lucanatorvs/refactored-robot/README.md

# refactored-robot
Combined Charging System Communication (CCSC)
