lucanatorvs/refactored-robot/StageVerslag/Abbrev.tex

\DeclareAcronym{ev}{
    short = {EV} ,
    long  = {Electric Vehicle} ,
    foreign  = {Elektrisch Voertuig} ,
    class = {abbrev}
}
\DeclareAcronym{evse}{
    short = {EVSE} ,
    long  = {Electric Cehicle Supply Equipment (EV charger)} ,
    foreign  = {Oplaadpunt} ,
    class = {abbrev}
}
\DeclareAcronym{ccs}{
    short = {CCS} ,
    long  = {Combined Charging System} ,
    foreign  = {Gecombineerd Laadsysteem} ,
    class = {abbrev}
}
\DeclareAcronym{ecu}{
    short = {ECU} ,
    long  = {Electronic Control Unit} ,
    foreign  = {Elektronische Regel Module} ,
    class = {abbrev}
}
\DeclareAcronym{hv}{
    short = {HV} ,
    long  = {High Voltage} ,
    foreign  = {Hoogspanning} ,
    class = {abbrev}
}
\DeclareAcronym{lv}{
    short = {LV} ,
    long  = {Low Voltage} ,
    foreign  = {Laagspanning} ,
    class = {abbrev}
}
\DeclareAcronym{ac}{
    short = {AC} ,
    long  = {Alternating Current} ,
    foreign  = {Wisselstroom} ,
    class = {abbrev}
}
\DeclareAcronym{dc}{
    short = {DC} ,
    long  = {Direct Current} ,
    foreign  = {Gelijkstroom} ,
    class = {abbrev}
}
\DeclareAcronym{can}{
    short = {CAN} ,
    long  = {Controller Area Network} ,
    foreign  = {Controller Gebiedsnetwerk} ,
    class = {abbrev}
}
\DeclareAcronym{bms}{
    short = {BMS} ,
    long  = {Battery Management System} ,
    foreign  = {Batterijbeheer Systeem} ,
    class = {abbrev}
}
\DeclareAcronym{hvil}{
    short = {HVIL} ,
    long  = {High Voltage Interlock Loop} ,
    foreign  = {Hoogspanning Interlock Lus} ,
    class = {abbrev}
}
\DeclareAcronym{hvi}{
    short = {HVIL} ,
    long  = {High Voltage Interlock} ,
    foreign  = {Hoogspanning Interlock} ,
    class = {abbrev}
}
\DeclareAcronym{pwm}{
    short = {PWM} ,
    long  = {Pulse Width Modulation} ,
    foreign  = {Pulsbreedte Modulatie} ,
    class = {abbrev}
}
\DeclareAcronym{soc}{
    short = {SOC} ,
    long  = {State of charge} ,
    foreign  = {Oplaad Niveau} ,
    class = {abbrev}
}
\DeclareAcronym{soh}{
    short = {SOH} ,
    long  = {Conditie} ,
    foreign  = {Oplaadstaat} ,
    class = {abbrev}
}
\DeclareAcronym{rdw}{
    short = {RDW} ,
    long  = {Rijksdienst voor het Wegverkeer} ,
    class = {abbrev}
}
\DeclareAcronym{dbc}{
    short = {DBC} ,
    long  = {CAN bus databases} ,
    foreign  = {CAN-Bus-Databases} ,
    class = {abbrev}
}
\DeclareAcronym{spi}{
    short = {SPI} ,
    long  = {Serial Peripheral Interface} ,
    foreign  = {Seriële Randapparatuur Interface} ,
    class = {abbrev}
}
\DeclareAcronym{ide}{
    short = {IDE} ,
    long  = {Integrated Development Environment} ,
    foreign  = {Geïntegreerde Ontwikkelomgeving} ,
    class = {abbrev}
}
\DeclareAcronym{psu}{
    short = {PSU} ,
    long  = {Power Supply Unit} ,
    foreign  = {Voeding} ,
    class = {abbrev}
}
\DeclareAcronym{usb}{
    short = {USB} ,
    long  = {Universal Serial Bus} ,
    foreign  = {Universelle Seriele Bus} ,
    class = {abbrev}
}
