lucanatorvs/refactored-robot/StageVerslag/Sources/Eindresultaat.tex

\chapter{Eindresultaat}
\label{Eindresultaat}
%%%%%%%%%%%%%%%%%%%%%%%%%%%%%%%%%%%%%%%%%%%%%%%%%%%%%%%%%%%%%%%%%%%%%%%%

Het eindresultaat is een kleine behuizing met een Arduino Pro Mini, een MPC2515
module, een DC-DC converter (als \ac{psu}) en een generieke \ac{usb}-serial
convertor (alleen nodig voor een Arduino Pro Mini).

Deze onderdelen zijn gekozen omdat ze makkelijk te verkrijgen en goedkoop
waren (en voor een groot deel op voorraad).

%%%%%%%%%%%%%%%%%%%%%%%%%%%%%%%%%%%%%%%%%%%%%%%%%%%%%%%%%%%%%%%%%%%%%%%%
\section{Schema}
%%%%%%%%%%%%%%%%%%%%%%%%%%%%%%%%%%%%%%%%%%%%%%%%%%%%%%%%%%%%%%%%%%%%%%%%

\begin{figure}[]
    \centering
    
    \caption{Schema van de bedrading van de CAN-controller aan de Arduino \cite{autowp}}
    \label{fig:wiring}
\end{figure}

In het schema in figuur \ref{fig:wiring} is te zien hoe de Arduino de
CAN-controller aan kan sturen. En hoe de Arduino gevoed word met de
\si{12\volt} uit de auto.

%%%%%%%%%%%%%%%%%%%%%%%%%%%%%%%%%%%%%%%%%%%%%%%%%%%%%%%%%%%%%%%%%%%%%%%%
\section{Behuizing}
%%%%%%%%%%%%%%%%%%%%%%%%%%%%%%%%%%%%%%%%%%%%%%%%%%%%%%%%%%%%%%%%%%%%%%%%

\begin{figure}[]
    \centering
    \begin{minipage}{0.45\textwidth}
        \centerline{}
        \caption{Behuizing van de CCS CAN controller}
        \label{fig:behuizing}
    \end{minipage}\hfill
    \begin{minipage}{0.45\textwidth}
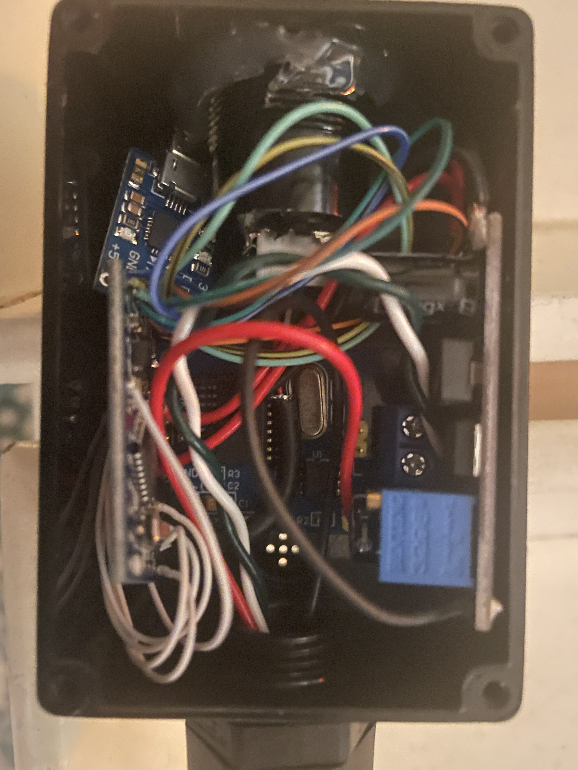
[picture p3: StageVerslag/Pictures/binnenkant.JPG]
        \centerline{}
        \caption{Binnenkant van de behuizing}
        \label{fig:binnenkant}
    \end{minipage}
\end{figure}

\begin{figure}[]
    \centering
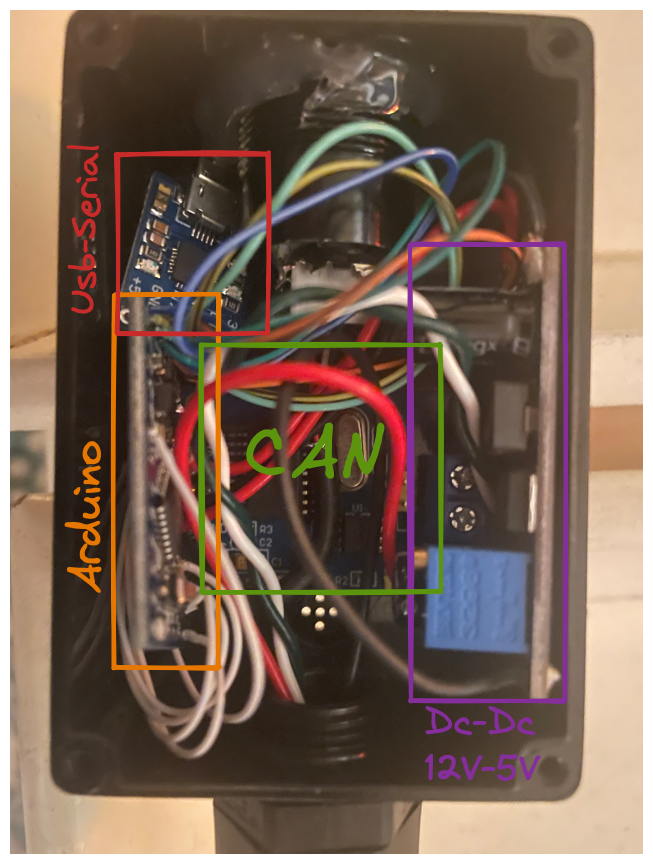
[picture p4: StageVerslag/Pictures/binnenkant_geanoteerd.png]
    
    \caption{Binnenkant van de behuizing, met een aantal notaties van de verschillende onderdelen}
    \label{fig:binnenkant_geanoteerd}
\end{figure}

In figuur \ref{fig:behuizing} is het eindresultaat te zien, een kleine lasdoos
is gebruikt als behuizing. De lasdoos heeft aan een kant een wartel als
doorvoer van de CAN bus en de \si{12\volt} uit de auto en aan de andere kant
een panel mount USB aansluiting. De USB aansluiting is om de Arduino te kunnen
programmeren. In figuur \ref{fig:binnenkant} en \ref{fig:binnenkant_geanoteerd} is de binnenkant van de behuizing
te zien. Het is best krap aan de binnenkant, maar alles past wel omdat er geen
gebruik meer word gemaakt van headers (zoals in het prototype), maar alle
verbindingen zijn direct aan de pcb's gesoldeerd.
