lucanatorvs/refactored-robot/StageVerslag/Sources/Titel.tex

\begin{titlepage}
    \vspace*{5cm}
    \makeatletter
    \begin{center}
        \begin{Huge}
            \@title
        \end{Huge}\\[0.1cm]
        %
        \begin{Large}
            \@subtitle
        \end{Large}\\
        %
        \emph{door}\\
        \@author
        %
        \vfill
        Dit document is opgesteld voor de stage bij EV Europe. Luca van
        Straaten is een student Elektrotechniek aan de Haagse Hogeschool te
        Delft.\\
        \vspace{.5cm}
        Datum: \today\\
        Versie: 1.0
    \end{center}
    \makeatother
\end{titlepage}

\newpage
