lucanatorvs/refactored-robot/StageVerslag/Sources/Voorwoord.tex

\chapter*{Voorwoord}
\addcontentsline{toc}{chapter}{Voorwoord}
%%%%%%%%%%%%%%%%%%%%%%%%%%%%%%%%%%%%%%%%%%%%%%%%%%%%%%%%%%%%%%%%%%%%%%%%

Dit ontwerpdocument is geschreven als documentatie van het tweede stagetraject
van Luca van Straaten.\\\

Dank gaat naar EV Europe voor de mogelijkheid om bij hun mijn tweede stage te
doen, te leren en groeien, nu en in de toekomst.\\\

Dit verslag is bedoeld voor mijn stage beoordeler om te beoordelen of ik
voldoende heb gepresteerd tijdens mijn stage, voor EV Europe en de mensen die
daar werken en verder moeten bouwen op mijn werk en voor Nederlandstalige
geïnteresseerden in het project. Een Engels vertaalde versie van dit verslag
is momenteel niet beschikbaar.\\\

Tijdens dit project is gewerkt in git, en alle bestanden staan op github. Als
iemand beniewd is naar bijvoorbeeld de arduino code, dan kan deze gedowload
worden van mijn \href{https://github.com/lucanatorvs}{GitHub} account onder de
project naam
\href{https://github.com/lucanatorvs/refactored-robot}{refactored-robot}.\\\

Delft, Januari 2022\\Luca van Straaten
