lucanatorvs/refactored-robot/StageVerslag/Sources/Conclusie_en_aanbevelingen.tex

\chapter{Conclusie en aanbevelingen}
\label{Conclusie_en_aanbevelingen}
%%%%%%%%%%%%%%%%%%%%%%%%%%%%%%%%%%%%%%%%%%%%%%%%%%%%%%%%%%%%%%%%%%%%%%%%

Uit dit verslag kan geconcludeerd worden dat dit project geslaagd is omdat het
product op tijd werd opgeleverd, en voldoet aan alle gestelde eisen.

Echter zijn er wel een aantal punten die kunnen worden verbeterd als dit
product in de toekomst vaak word verkocht. Zo kunnen alle losse onderdelen die
nu in de behuizing zitten op een pcb worden gezet, om zo een robuuster product
te maken dat makkelijk te produceren en waarschijnlijk ook nog goedkoper is.
Een CAN-controller zoals dit kan ook nog ander toepassingen hebben voor een
bedrijf als EV Europe.\\

Dat is niet nodig als de producent van het BMS direct firmware zou kunnen
leveren dat de juiste data aan het CCS-modem aanlevert. Als dat wordt gedaan,
dan zal het product niet meer nodig zijn en om Elon Musk te citeren, het beste
component, is geen component.
