lucanatorvs/refactored-robot/StageVerslag/Sources/Samenvatting.tex

\chapter{Samenvatting}
\label{Samenvatting}
%%%%%%%%%%%%%%%%%%%%%%%%%%%%%%%%%%%%%%%%%%%%%%%%%%%%%%%%%%%%%%%%%%%%%%%%

\begin{center}
    \begin{minipage}{0.5\textwidth}
        \begin{small}
            Waar in het kort het project van begin tot eind wordt beschreven.
        \end{small}
    \end{minipage}
    \vspace{0.5cm}
\end{center}

Er moest een systeem worden ontworpen om CCS snelladen te implementeren in een
elektrische auto. Er zijn verschillende optie overwogen, zoals zelf alle
elektronica ontwerpen. Maar uiteindelijk is er voor gekozen om een modem van
Zero-EV te gebruiken. Hiervoor moest een communicatie verbinding tussen het BMS
en het modem worden gemaakt. Dit is geïmplementeerd met een CAN bus
controller, maar kan in de toekomst direct vanuit het BMS.

Hoe er tot dit ontwerp, deze optie en het ontwerp van de CAN controller is
gekomen, staat uitgewerkt in dit verslag.

% %%%%%%%%%%%%%%%%%%%%%%%%%%%%%%%%%%%%%%%%%%%%%%%%%%%%%%%%%%%%%%%%%%%%%%%%
% \section{Vooraf}
% %%%%%%%%%%%%%%%%%%%%%%%%%%%%%%%%%%%%%%%%%%%%%%%%%%%%%%%%%%%%%%%%%%%%%%%%

% Bepaalen wat er moet worden gedaan en een plan van aanpak en een plan van eisen opstellen. 

% %%%%%%%%%%%%%%%%%%%%%%%%%%%%%%%%%%%%%%%%%%%%%%%%%%%%%%%%%%%%%%%%%%%%%%%%
% \section{Tijdens het project}
% %%%%%%%%%%%%%%%%%%%%%%%%%%%%%%%%%%%%%%%%%%%%%%%%%%%%%%%%%%%%%%%%%%%%%%%%

% Onderzoek doen naar de mogelike opties en die implementeeren.

% %%%%%%%%%%%%%%%%%%%%%%%%%%%%%%%%%%%%%%%%%%%%%%%%%%%%%%%%%%%%%%%%%%%%%%%%
% \section{Testen van het product}
% %%%%%%%%%%%%%%%%%%%%%%%%%%%%%%%%%%%%%%%%%%%%%%%%%%%%%%%%%%%%%%%%%%%%%%%%

% langs laaders
