lucanatorvs/refactored-robot/StageVerslag/Appendices/Verantwoording_behaalde_competenties/competenties.md

# verantwoording van de behaalde competenties

Hier zal ik mijn behaalde competenties verantwoorden. Mijn stagebegeleider
heeft al toegekend dat ik op het gebied van de drie competenties goed heb
gepresteerd.

## Analyseren

Ik heb aan het begin van het project de ontwerpeisen opgesteld aan de hand van
de klantbehoefte, en zo verschillende ontwerpstrategieën bedacht. Daar heb ik
een van gekozen die uiteindelijk tot een werkend product leiden.

## Managen

Tijdens mijn tijd bij EV Europe, heb ik niet alleen aan het CCS-project
gewerkt, maar heb ik ook bijgesprongen op momenten waar extra mankracht nodig
was. Een voorbeeld hiervan m.b.t. de competentie managen, is dat ik een andere
stagiair instructie heb gegeven over hoe hij stekker aan kabel moet krimpen. Ik
heb hem hiermee geholpen, en gecontroleerd dat hij het werk goed verrichten.

## Onderzoeken

Ik heb onderzoek gedaan naar alle aspecten waar het project mee te maken heeft.
Zoals elektrische auto's, lader en de CAN-bus. Ik heb alle relevante informatie
die ik heb gevonden, opgenomen in het ontwerp en het verslag, en ik heb de
gebruikte bronnen ook opgenomen.
