lucanatorvs/refactored-robot/StageVerslag/Appendices/Bedrijfsorganisatie/organisatie.md

# korte beschrijving van de bedrijfsorganisatie
