lucanatorvs/refactored-robot/StageVerslag/Pictures/zeroev_layout.png

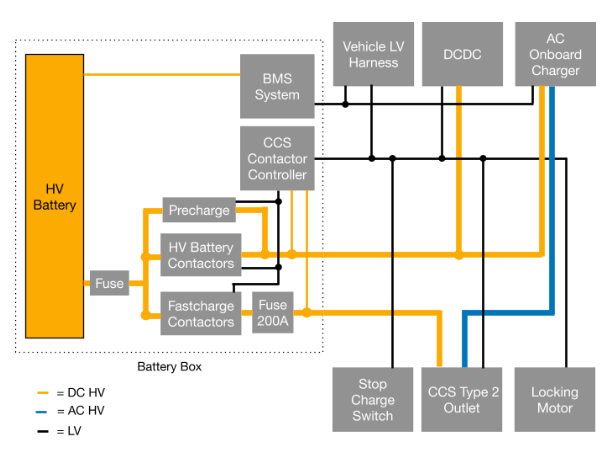
StageVerslag/Pictures/zeroev_layout.png
