lucanatorvs/refactored-robot/StageVerslag/Sources/Evaluatie.tex

\chapter{Evaluatie}
\label{Evaluatie}
%%%%%%%%%%%%%%%%%%%%%%%%%%%%%%%%%%%%%%%%%%%%%%%%%%%%%%%%%%%%%%%%%%%%%%%%

Het eindresultaat is een werkende CCS-opstelling, dat was uiteraard het doel
van het project en daarom is het project geslaagd. Er zijn dus dingen goed
gegaan, maar er zijn ook verbeterpunten, die mij in de toekomst kunnen helpen.

%%%%%%%%%%%%%%%%%%%%%%%%%%%%%%%%%%%%%%%%%%%%%%%%%%%%%%%%%%%%%%%%%%%%%%%%
\section{Wat ging er goed}
%%%%%%%%%%%%%%%%%%%%%%%%%%%%%%%%%%%%%%%%%%%%%%%%%%%%%%%%%%%%%%%%%%%%%%%%

Naast het opleveren van het eindproduct binnen de gestelde tijd, heb ik het erg
naar mijn zin gehad binnen het bedrijf. Het was aan het begin wennen om met
mijn collega's om te gaan. Maar toen ik hen, en zij mij beter leerde kennen,
heb ik het idee dat we het erg naar ons zin hadden.

%%%%%%%%%%%%%%%%%%%%%%%%%%%%%%%%%%%%%%%%%%%%%%%%%%%%%%%%%%%%%%%%%%%%%%%%
\section{Wat kan verbeterd worden}
%%%%%%%%%%%%%%%%%%%%%%%%%%%%%%%%%%%%%%%%%%%%%%%%%%%%%%%%%%%%%%%%%%%%%%%%

Achteraf zijn er nog een aantal punten waar ik aan kan werken. Zo was er soms
(zeker aan het begin) niet genoeg communicatie tussen mij en de opdrachtgever,
waardoor het voor hem niet duidelijk was waar ik mee bezig was, en of ik nog op
schema liep.

Ook was de planning die ik aan het begin had gemaakt, niet gevolgd en heb ik de
hele planning op gevoel gedaan. Dat is dit keer goed uitgekomen, maar in de
toekomst lijkt het me handig om me aan de planning te houden.
