lucanatorvs/refactored-robot/(commit log)

2021-12-20 helft van de verbeteringen pva
2022-01-13 add can convertor arduino program
2022-01-18 arduino code improved with error handelig
    [CAN_convertor.ino]
2022-01-26 arduino code werkend maar zonder LUT
