lucanatorvs/refactored-robot/StageVerslag/Pictures/behuizing.JPG

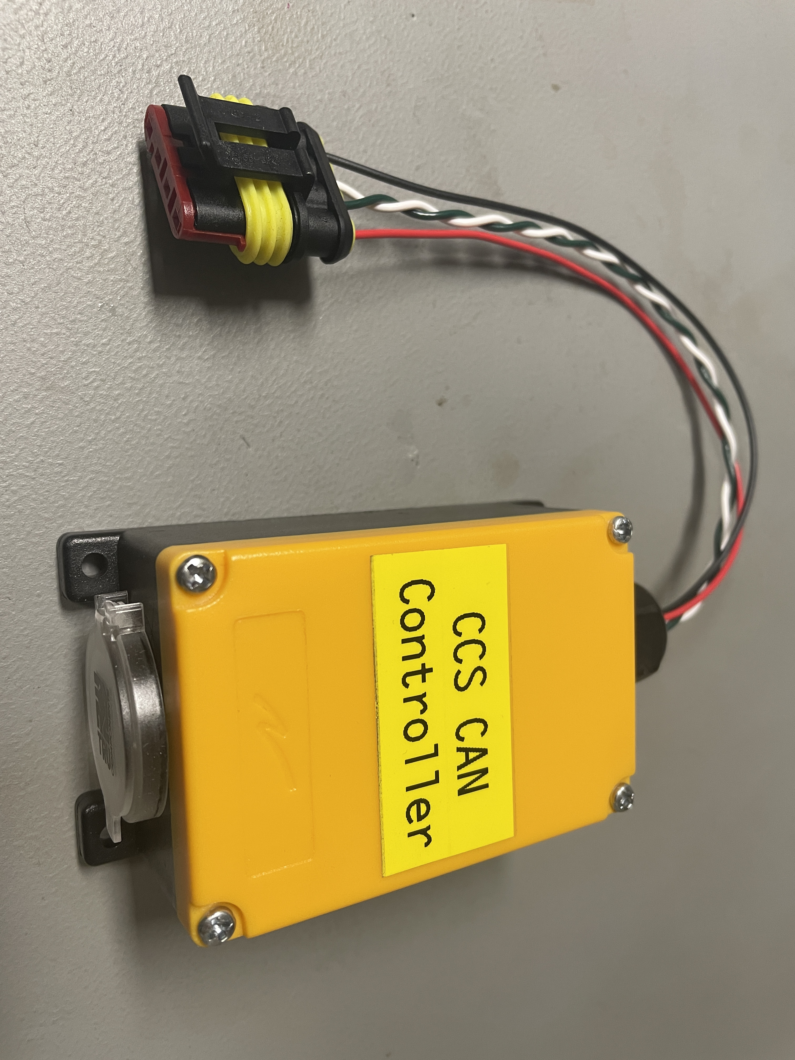
[picture p2: StageVerslag/Pictures/behuizing.JPG]
StageVerslag/Pictures/behuizing.JPG
